trebtrebeon/Banc-acer/05-Conception/05-Conception/05-Conception/Conception Structure.pptx

1000mm

1300mm

1000mm

870mm

## Slide 2

1300mm

1000mm

1000mm

870mm

## Slide 3
