trebtrebeon/Banc-acer/05-Conception/05-Conception/05-Conception/Structure.pptx

1000mm

1300mm

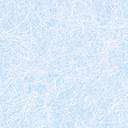
[picture p1: figure]
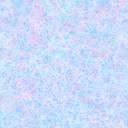
[picture p2: figure]

1000mm

870mm
