trebtrebeon/Banc-acer/01-Cahier des charges/01-Cahier des charges/01-Cahier des charges/Compte rendu du cahier des charges V2.docx

Compte rendu du cahier des charges V2

Suite à la relecture du cahier des charges V2 du projet "Mesure des dimensions des colis" pour le client ACER, nous avons relevé plusieurs incohérences entre le document et ce qu'il nous a été dit lors de la visite chez ACER.

- Le titre du projet est à changer sur les futurs documents : actuellement le projet est appelé "Mesure du volume des colis" alors que son nom réel devrait être "Mesure des dimensions des colis".
- Idem dans le paragraphe des objectifs : actuellement le projet est appelé "Mesure du volume des colis" alors que son nom réel devrait être "Mesure des dimensions des colis".
- Les dimensions des colis communiqués dans le cahier des charges sont erronées, suite à des mesures sur les cartons que nous avons réceptionner de votre part, la plus grande longueur est de 1100 mm, la plus grande largeur est de 650 mm et la plus grande hauteur est de 600 mm.
- Lors de notre visite dans vos services, vous nous avez donné la date de réception (Q1 2020), cependant, sur le document, il est inscrit Q4 2019.

Un retour du client est attendu suite à ce compte rendu du cahier des charges V2.

BTS SNEC 2ème année Projet ACER - Mesure des dimensions des colis
