trebtrebeon/Banc-acer/01-Cahier des charges/01-Cahier des charges/01-Cahier des charges/Résumé des modifications du cahier des charges.docx

Créé le 15/11/19

Modification :

Ajout :

Précision apportée dans le titre et dans l’objectif (volume=>dimensions). Mise à jour des dimensions maximales des cartons. Date de finalisation du projet repoussée à Q1 2020.

Avant Modif :

L‘objectif du projet est de concevoir et fournir un système de mesure du volume des colis.

Après Modif :

L‘objectif du projet est de concevoir et fournir un système de mesure des dimensions des colis.

Avant Modif :

Carton le plus grand : BOX MIXTE : 750x650x400

Carton le plus long : ASPI BALAI : 893x240x302

Carton le plus petit : BOX SMARTPHONE : 200x200x50

Après Modif :

Longueur de carton la plus grande : 110cm

Largeur de carton la plus grande : 65 cm

Hauteur de carton la plus grande : 60cm

Avant Modif :

L’objectif est de finaliser le projet Q4 2019.

Après Modif :

L’objectif est de finaliser le projetpourQ1 2020.
