trebtrebeon/Banc-acer/Projet Acer/Projet Acer/Compte rendu/Compte rendu de la visite Acer.docx

Projet Acer

Tâche en cours de réalisation

- Debug et réécriture du code pour L’écran LCD (Création de la bibliothèque)
- Il sera fourni une documentation d’utilisation.
- Remettre en ordre le dossier avec toutes les documentations techniques. Refaire les schémas de câblage s’il y a besoin.
- Au moment de la livraison, il sera fourni au client des pièces supplémentaire (hors armature) en cas de panne. → Faire un inventaire de toutes les pièces et les commander.

Compte rendu de la visite chez ACER du 14/12/2020

Problème rencontré :

Penser à une autre position de l’écran LCD (le mettre en dessous de la table)

Rajouter des marquages sur la table

Rallongé les buttées environ de 50cm.

Capteur de présence est très sensible à la luminosité.

Il y avait une continuité entre la masse et le 5v sur la carte de prototypage.

Solution :

Capteur de présence : Modification du programme et test ok.

Continuité : Nous avons dessoudé la LED et ça a fonctionné

A faire :

Précision de poids à la centaine de gramme, 50kg

Rallonger le mat pour plus de solidité

Niveau à bulle dans la table pour la mesure plane

Modification des roues.
