trebtrebeon/Banc-acer/Manuel d'utilisation- Banc de mesures Acer.pdf

# Manuel d’utilisation banc de mesures

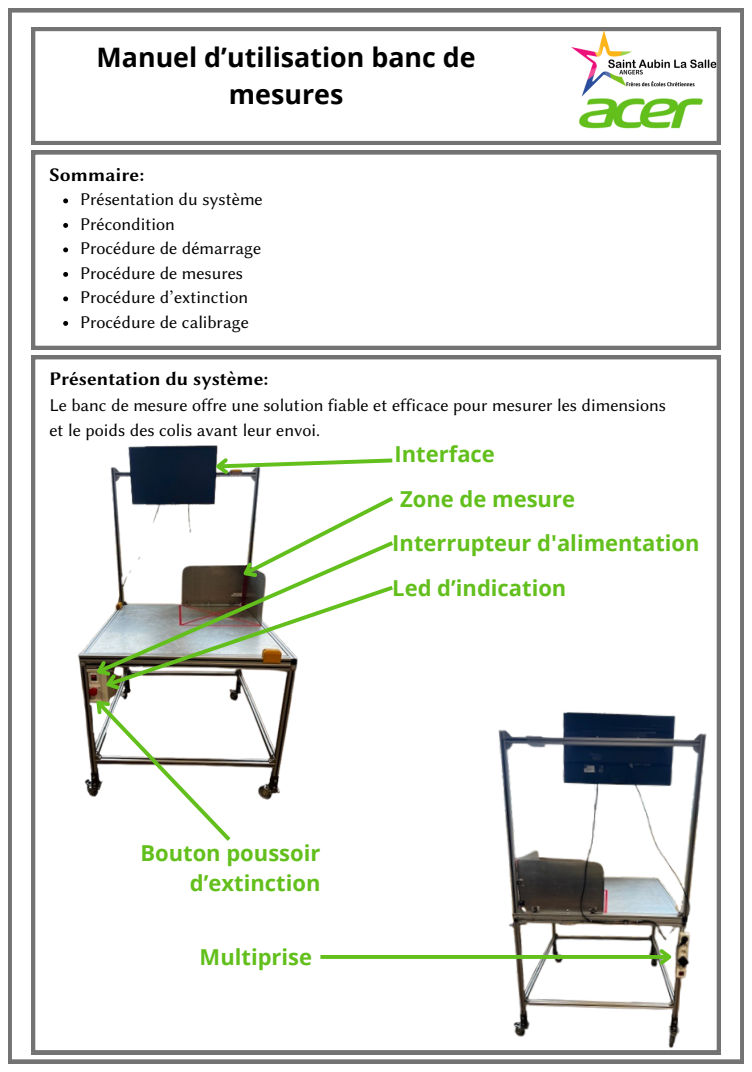
[picture p3: page 1]
Bouton poussoir d’extinction; Multiprise

Sommaire:
Présentation du système
Précondition
Procédure de démarrage
Procédure de mesures
Procédure d’extinction
Procédure de calibrage

Présentation du système:
Le banc de mesure offre une solution fiable et efficace pour mesurer les dimensions
et le poids des colis avant leur envoi.

Interface
Zone de mesure
Interrupteur d'alimentation
Led d’indication

Précondition:
1.Vérifiez que l’interrupteur d'alimentation situé sur la façade est en position OFF (symbole O).
2.Assurez-vous que la multiprise est soit bien branchée et en position OFF (symbole O).
3.Vérifiez qu'il n'y a aucun objet posé sur le banc.

Procédure de démarrage:
1.Allumez la multiprise en position ON (symbole | ).
2.Passez le bouton d'alimentation en position ON (symbole | ).
3.L’écran s’allume et après un certain temps, l’application se lance.

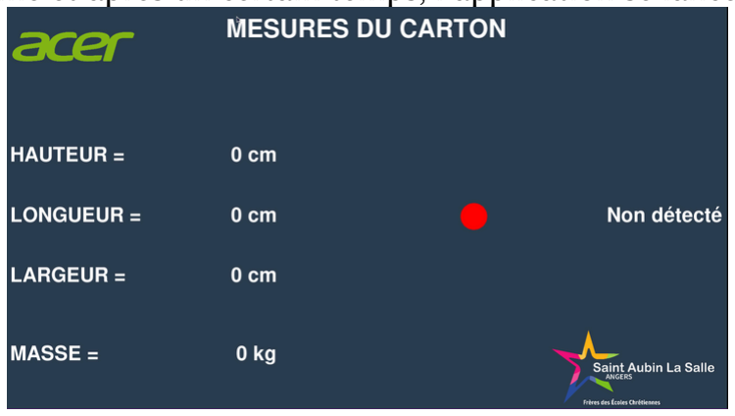
[picture p4: figure]

Procédure de mesures:
1.Placez un carton dans la zone de mesure identifiée (poussez-le jusqu’à la butée). 2.L’indicateur sur l’interface passe en orange la mesure est en cours

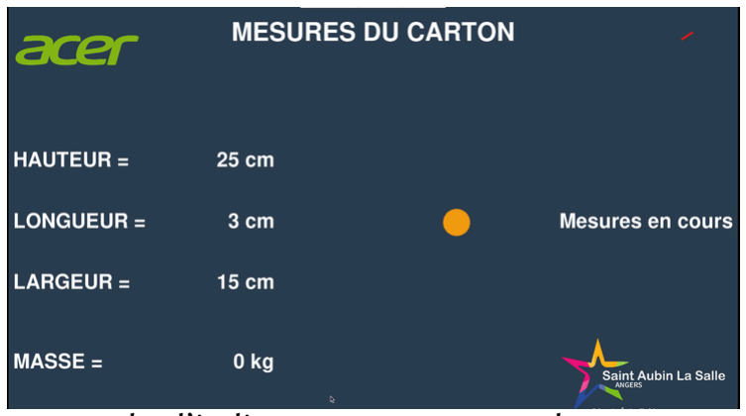
[picture p5: figure]

3.Après quelques secondes l’indicateur passe en vert la mesure est effectué

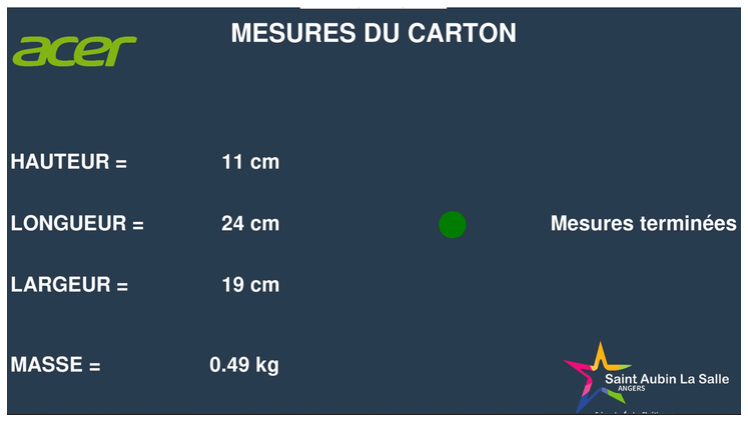
[picture p6: figure]

Procédure d’extinction:
1.Appuyez sur le bouton poussoir d’extinction de la façade et maintenez l’enfoncé jusqu’à la fin du décompte (3 secondes).
2.Attendez que la LED verte (à coté du bouton d’alimentation) soit complètement éteinte.
3.Coupez l'alimentation avec l'interrupteur situé sur la façade (symbole O). 4.Éteignez la multiprise (symbole O).

Procédure de calibrage:
1. Approcher la souris dans le coin haut droit, et le menu calibrage apparaît et . cliquez dessus.
2. Appuyer sur “Lancer le calibrage”
3. Lorsqu’il est affiché (voir image ci-jointe), poser une masse de 20kg dans la zone . de mesure.
4. Lorsqu’il est affiché (voir image ci-jointe), poser une masse de 20kg dans la zone . de mesure.
5. Une fois le calibrage terminé, vous pouvez quitter le menue
