trebtrebeon/Banc-acer/01-Cahier des charges/01-Cahier des charges/01-Cahier des charges/2019-09-24 - Compte rendu visite Acer.docx

# Compte-rendu visite Acer (24/09/19) : Classe de SNEC 2 (Promo 2018-2020), M. Gaudichet, M. Chenus, M. Huteau.

Que fait concrètement l’utilisateur et que devra-t-il faire ?
Que fait l’utilisateur de la mesure ?

- L’opérateur emballe le produit, il prend les dimensions au mètre, il pèse le colis et entre les informations (poids/dimensions) pour avoir le poids volumétrique ce qui va déterminer le coût de transport. Tout est actuellement manuel.

Les cartons sont-ils tous parallélépipédiques ? Sinon, quelles formes ?
De quel espace disposons-nous pour adapter le système ?

- Tous les cartons sont parallélépipédiques et le poste d’installation de l’équipement est aménageable.
- La balance sur laquelle est posé le carton pourra être prise en compte dans la conception dans l’optique de concevoir un système permettant d’éviter une manipulation supplémentaire (prise de dimensions et pesage simultanés). Attention cependant : si une balance tombe en panne, elle sera remplacée par une autre balance pas forcément identique à la première. Ce point ne fait pas partie du cahier des charges initial et n’est donc pas une exigence prioritaire.

Sur quelle durée l’équipement sera-t-il utilisé ?

- Plus de 100 cartons sont mesurés par jour, à une fréquence de 5 jours sur 7 et pendant 7 heures par jour maximum.

Que comprenez-vous dans un coût objectif >500 € ? Ce coût est-il considéré Hors Taxes ou Toutes Taxes Comprises ?

- Le coût objectif de moins de 500 euros HT comprend le matériel nécessaire pour un système. Il a été proposé par le technicien méthode de faire un coin pour caler le carton.

Les résultats doivent-ils être enregistrés ? Sur le réseau ? Si oui, quel est le type de réseau utilisé et comment pouvons-nous y accéder ?

- Les dimensions seront enregistrées dans un espace de stockage externe (disque dur ou clé USB) avec éventuelle réinitialisation.

Que voulez-vous dire par une précision au cm³ ? Sachant que cela demanderait, par exemple, pour la dimension carton BOX MIXTE (750x650x400), une précision capteur de 2µm (ce qui est clairement impossible) ?

- Les dimensions seront affichées en centimètre et auront une précision au centimètre près.

Pouvons-nous afficher autre chose que le résultat à l’écran, commentaires, indications… ?

- Il est possible d’afficher des messages ou autres informations à l’écran.

CFA EC 49 – 15 rue Hélène Boucher, Saint Sylvain d’Anjou, 49481 Verrières en Anjou. Hélène Boucher, Saint Sylvain d’Anjou, 49481 Verrières en ANJOU 1

Projet Acer
