trebtrebeon/Banc-acer/04-Etudes/04-Etudes/04-Etudes/études old/02-Afficheur/Document de conception - Afficheur.docx

Document de conception

Afficheur

Câblage :

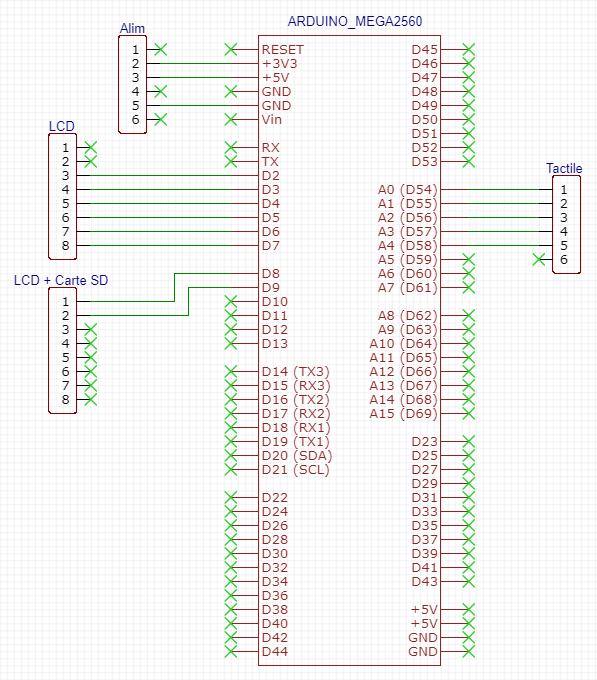
[picture p17: figure]

Interface graphique :

3,5 pouces / 76,2 mm

7,34 mm

4,89 mm

Longueur : xxx,xx cm

Largeur : xxx,xx cm

Hauteur : xxx,xx cm

Date : xx/xx/xxxx

Heure : xxhxxmin

75 pix

110 pix

Longueur : xxx,xx cm

Largeur : xxx,xx cm

Hauteur : xxx,xx cm

Date : xx/xx/xxxx

Heure : xxhxxmin

125 pix

110 pix

Longueur : xxx,xx cm

Largeur : xxx,xx cm

Hauteur : xxx,xx cm

Date : xx/xx/xxxx

Heure : xxhxxmin

200 pix

90 pix

Longueur : xxx,xx cm

Largeur : xxx,xx cm

Hauteur : xxx,xx cm

Date : xx/xx/xxxx

Heure : xxhxxmin

250 pix

70 pix

Longueur : xxx,xx cm

Largeur : xxx,xx cm

Hauteur : xxx,xx cm

Date : xx/xx/xxxx

Heure : xxhxxmin

100 pix

25 pix

Software :

1) Librairie pour utilisation de l’écran
2) Définition des constantes

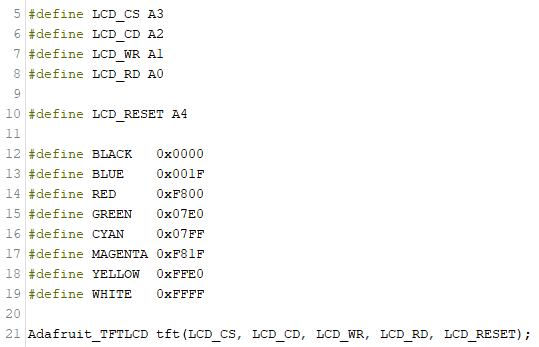
[picture p18: figure]

Partie définition des pins

Partie définition des couleurs

3) Starter

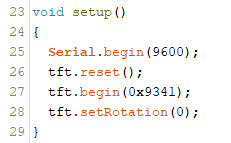
[picture p19: figure]

4) Boucle principal

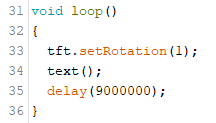
[picture p20: figure]

5) Fonction « text »

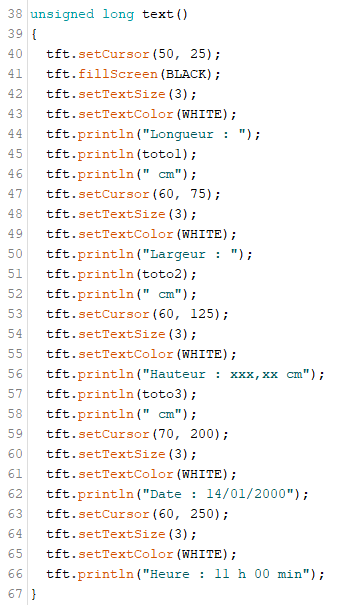
[picture p21: figure]

Partie affichage de la longueur

Partie affichage de la largeur

Partie affichage de la hauteur

Partie affichage de la date

Partie affichage de l’heure

Définition de la couleur de l’écran

Paramétrage Arduino :

Pour choisir le type d’Arduino, il faut aller dans l’onglet « OUTILS », dans la 3ème partie.

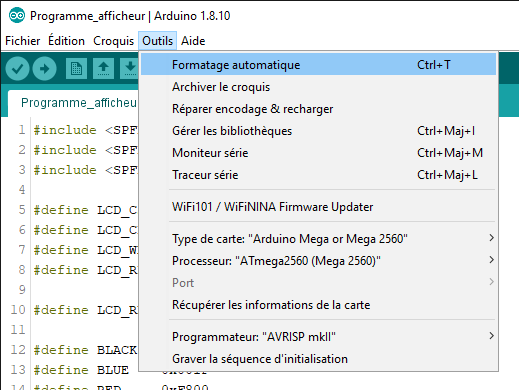
[picture p22: figure]

Paramètre Arduino

Modification taille écran :

Lors du 1er téléversement du programme, l’écran s’affichera en taille réduit, pour cela, il faut :

1) Ouvrir le dossier de la librairie utiliser pour l’afficheur : « SPFD5408-master »
2) Ouvrir le fichier : « SPFD5408_Adafruit_TFTLCD.cpp »
3) Une fois ouvert, il faut mettre en commentaire les lignes 35-36 et décommenter les lignes 32-33

Modification orientation :

Si l’écran n’est pas horizontal, il faut modifié une information dans le code, la procédure est la suivante :

1) Ouvrir le programme du projet
2) Aller dans le « Setup »
3) Sur la ligne « tft.setRotation(x) », au niveau du x, il faut mettre un 1 ou un 0.
