trebtrebeon/Banc-acer/05-Conception/05-Conception/05-Conception/Câblage alimentation.PNG

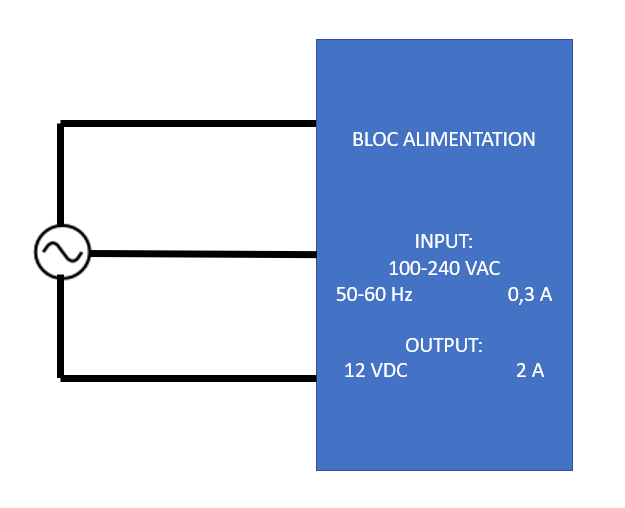
05-Conception/05-Conception/05-Conception/Câblage alimentation.PNG
