trebtrebeon/Banc-acer/05-Conception/05-Conception/05-Conception/devis technic-achat.PNG

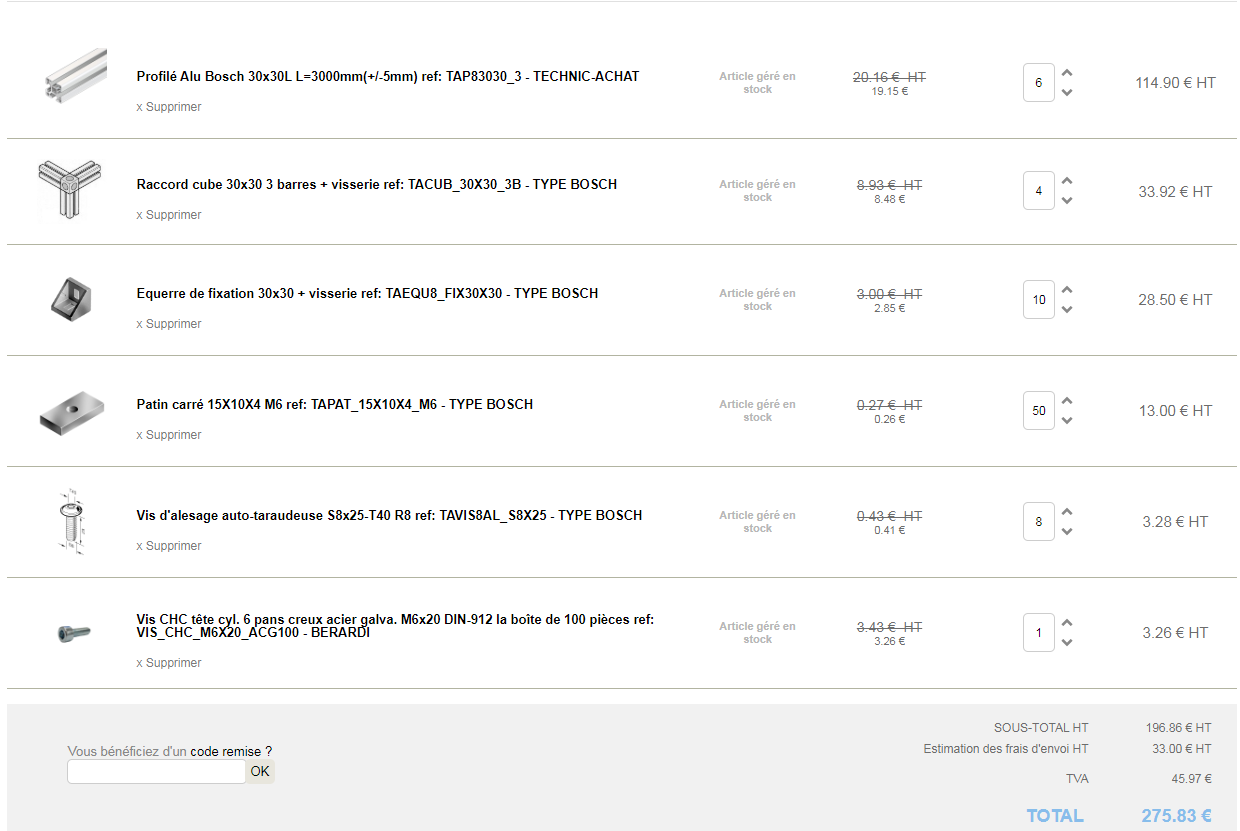
05-Conception/05-Conception/05-Conception/devis technic-achat.PNG
