trebtrebeon/Banc-acer/05-Conception/05-Conception/05-Conception/Schema de cablage capteurs.png

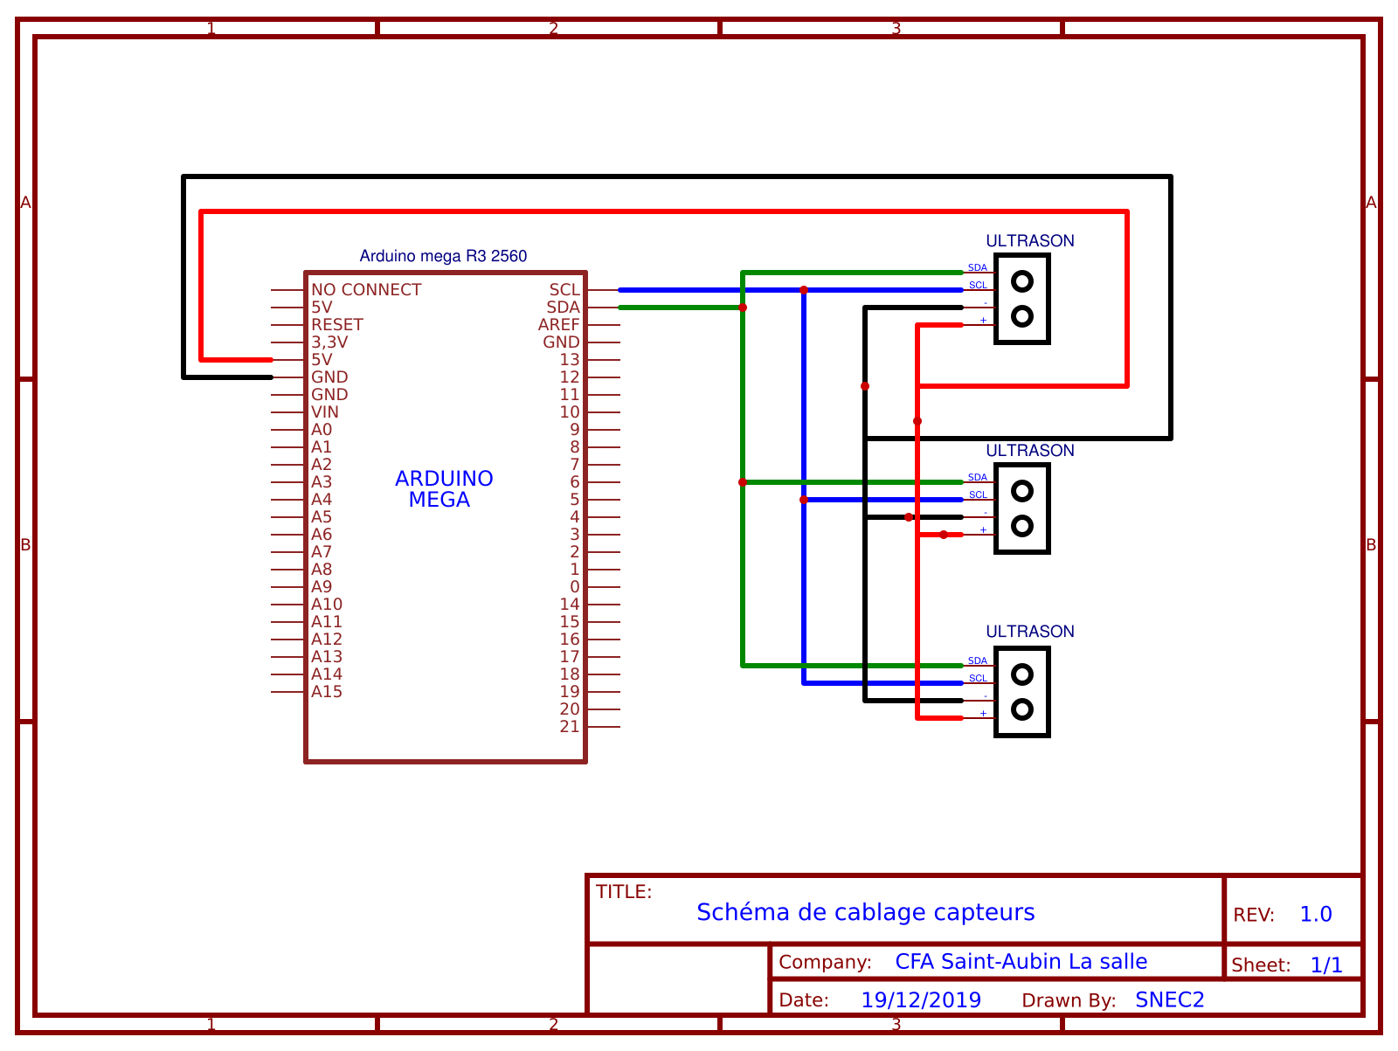
05-Conception/05-Conception/05-Conception/Schema de cablage capteurs.png
