trebtrebeon/Banc-acer/CodesSources/pi/ACER.png

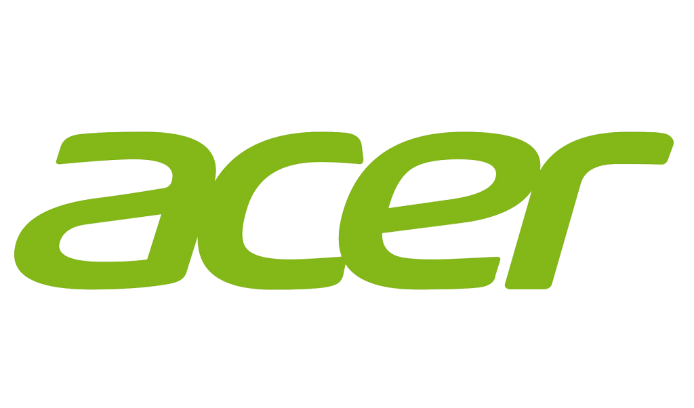
CodesSources/pi/ACER.png
