trebtrebeon/Banc-acer/CodesSources/pi/SALS.png

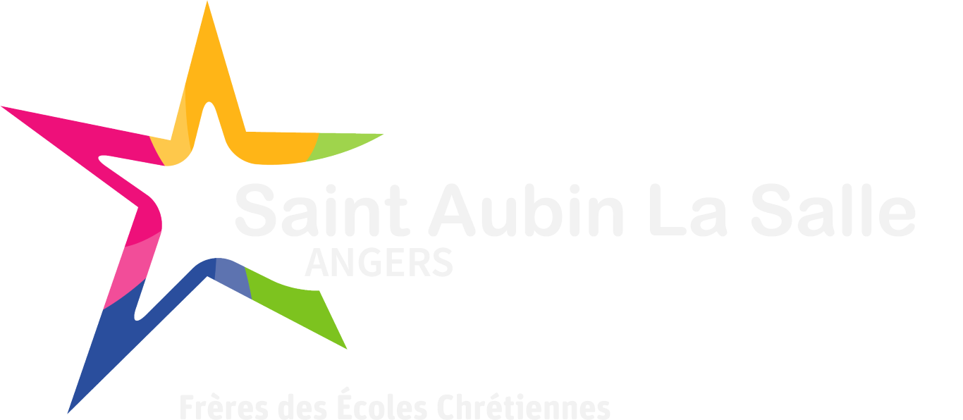
CodesSources/pi/SALS.png
