trebtrebeon/Banc-acer/Projet Acer/Projet Acer/Capteurs/Capteur Ultrasons/Schéma_Câblage_HC-SR04.PNG

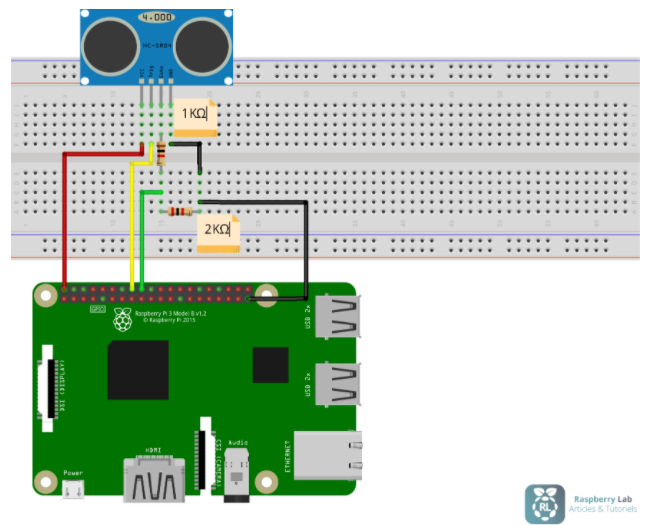
Projet Acer/Projet Acer/Capteurs/Capteur Ultrasons/Schéma_Câblage_HC-SR04.PNG
