trebtrebeon/Banc-acer/Projet Acer/Projet Acer/Méca/Roue/Spécification roulette.PNG

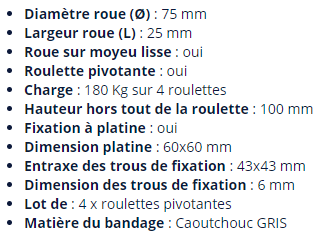
Projet Acer/Projet Acer/Méca/Roue/Spécification roulette.PNG
