trebtrebeon/Banc-acer/05-Conception/05-Conception/05-Conception/commande projet Acer.xlsx

Liste matériel projet ACER (Hors Armature)
Désigantion | Caractéristique | Fournisseur | Référence | Prix HT Unitaire | Unité | Quantité | Prix HT
Arduino MEGA 2560 | Français | Amazon |  | 9.04 € | U | 1 | 9.04 € | https://www.amazon.fr/Semoic-Mega2560-Atmega2560-16AU-Compatible-Arduino/dp/B07PTZ5JV4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
Alimentation Arduino | 12V 2A | Amazon |  | 9.99 € | U | 1 | 9.99 € | https://www.amazon.fr/ZOSI-Adaptateur-Secteur-dalimentation-Transformateur/dp/B015MGWBYE?s=electronics
Module enregistrement |  | Amazon |  | 4.69 € | U | 1 | 4.69 € | https://www.amazon.fr/DEnregistrement-Donn%C3%A9es-DAcquisition-Bouclier-DEnregistreur/dp/B07Y23H6L3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
Carte SD | 4 Go | Amazon |  | 7.99 € | U | 1 | 7.99 € | https://www.amazon.fr/dp/B002WE6CTU/ref=twister_B07STFZ1GF
Écran LCD TFT | 3,5" | Amazon |  | 14.99 € | U | 1 | 14.99 € | https://www.amazon.fr/%C3%89cran-r%C3%A9solution-Support-Arduino-%E2%80%BFMEGA/dp/B07N4KXP5X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
Capteurs lasers | 2 m | Amazon |  | 4.41 € | U | 3 | 13.23 € | https://www.amazon.fr/Tree-Life-GY-VL53L0XV2-d%C3%A9rivation-Distance/dp/B07QZR61D2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
Câbles | 6 bobines | Amazon |  | 16.99 € | U | 1 | 16.99 € | https://www.amazon.fr/d%C3%A9lectronique-silicone-diff%C3%A9rentes-R%C3%A9sistance-temp%C3%A9ratures/dp/B07G715HYY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
Câble 3G | 5 m | Mano Mano |  | 0.69 € | L | 5 | 3.45 € | https://www.manomano.fr/p/cable-r2v-3g4-8540275?model_id=8540287
Fiche électrique |  | Amazon |  | 4.99 € | U | 1 | 4.99 € | https://www.amazon.fr/Legrand-LEG93828-Fiche-Etanche-Plexo/dp/B00A7MCCIY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
Capteurs ultrasons |  | MouserElectronic |  | 11.61 € | U | 3 | 34.83 € | https://www.mouser.fr/ProductDetail/DFRobot/SEN0304
 |  |  |  |  |  | Total | 120.19 €
