trebtrebeon/Banc-acer/Projet Acer/Projet Acer/Bon de commande/Commande projet Acer.xlsx

Mise à jour du bon de commande 13/12/2020
N° Article | Description | Fournisseur | Qté Livrée | Prix HT Unitaire | Prix TTC | Documentation technique
34732 | Amplificateur pour capteur de force SEN-13879 | GO TRONIC | 2 | 10.80 € | 21.60 € | https://www.gotronic.fr/art-amplificateur-pour-capteur-de-force-sen-13879-25334.htm#complte_desc
RB-Spa-488 | Capteur de poids 50 kg SFE | Robot Shop | 4 | 9.28 € | 37.12 € | https://www.robotshop.com/eu/fr/capteur-poids-50-kg-sfe.html
/ | Aussel Câble plat de couleur d'arc-en-ciel de câble de 1.27mm pour des connecteurs de 2.54mm (30Wire/3M) | Amazon | 1 | 9.99 € | 9.99 € | https://www.amazon.fr/Aussel-couleur-darc-en-ciel-1-27mm-connecteurs/dp/B077XF5LXH
/ | QLOUNI 560 pcs 18-26 AWG Connecteur JST-XHP Câble Kit 2.54mm Femelle Pin Header JST-PH 2/3/4/5 Pin Connecteur Mâle et Femelle | AMAZON | 1 | 12.99 € | 12.99 € | https://www.amazon.fr/dp/B0774R1RN1
6662893 | Connecteur Sub-D HARTING 15 voies Femelle Montage sur câble Droit | RS Components | 2 | 3.32 € | 16.31 € | https://fr.rs-online.com/web/p/connecteurs-sub-d/6662893/
/ | LINDY Support pour Ecran avec Mât et Fixation à Pince | AMAZON | 1 | 32.63 € | 32.63 € | https://www.amazon.fr/LINDY-Support-Ecran-Fixation-Pince/dp/B083PDBJ25
ME4024847 | Lot roulettes pivotantes caoutchouc gris 75 mm - 180 Kg | Mano Mano | Lot de 4 | 17.89 € | 17.89 € | https://www.manomano.fr/p/lot-roulettes-pivotantes-caoutchouc-gris-75-mm-180-kg-4024847
104155 | Boîtier Fibox TEMPO en ABS, 187.2 x 122.2 x 89.9mm, Gris IP65 | RS Components | 1 | 10.75 € | 12.90 € | https://fr.rs-online.com/web/p/boitiers-pour-usage-general/0104155/
/ | ELEGOO 5 pièces HC-SR04 Module Ultrason de Capteur de Distance Ultrasonic Module Distance Sensor | AMAZON | 5 | / | 8.99 € | https://www.amazon.fr/gp/product/B06XSJPVW9/ref=ox_sc_act_title_1?smid=AZF7WYXU5ZANW&psc=1
/ | SanDisk Carte Mémoire MicroSDHC Ultra 32 Go + Adaptateur SD. Vitesse de Lecture Allant jusqu'à 98MB/S, Classe 10, U1, homologuée A1 | AMAZON | 1 | 8.74 € | 8.74 € | https://www.amazon.fr/gp/product/B073JWXGNT/ref=ox_sc_act_title_2?smid=A3CNB4T4PHDD3G&psc=1
/ | RAMPOW Câble USB Type C vers USB 3.0, Câble USB C Charge Rapide 3A, Chargeur USB C Nylon Tressé avec Connecteur Résistant pour Samsung S8/S9/S10 Note 10, Xiaomi, Sony et Plus - 1m/Gris Sidéral | AMAZON | 1 | 6.99 € | 6.99 € | https://www.amazon.fr/gp/product/B01N4OKUB8/ref=ox_sc_act_title_3?smid=A54WM2317NJ70&th=1
/ | Câble micro HDMI vers HDMI par LinkinPerk, câble HDMI haute vitesse vers micro HDMI HDTV, prend en charge Ethernet, 3D, 4 K et retour audio | AMAZON | 1 | 8.09 € | 8.09 € | https://www.amazon.fr/gp/product/B072J9FLN4/ref=ox_sc_act_title_4?smid=A3M5K1HE9PQRI0&psc=1
/ | Raspberry Pi 4 Modèle B 4 Go ARM-Cortex-A72 4 x 1,50 GHz, 4 Go de RAM, WLAN-AC, Bluetooth 5, LAN, 4 x USB, 2 x Micro HDMI | RS Components | 1 | 49.21 € | 59.05 € | https://fr.rs-online.com/web/p/raspberry-pi/1822096/
