trebtrebeon/Banc-acer/05-Conception/05-Conception/05-Conception/DEVIS STRUCTURE.xlsx

DESCRIPTION | FOURNISSEUR | RÉFERENCE | PRIX TTC | PRIX HT | QUANTITÉ | PRIX TOTAL HT
Profilé aluminium 30x30, rainures 8mm, longueur 3000mm | Technic-Achat | TAP83030_3 | 24.26 € | 20.22 € | 6 | 121.32 €
Raccord cube 30x30, 3 barres + visserie | Technic-Achat | TACUB_30x30_3B | 10.72 € | 8.93 € | 4 | 35.72 €
Equerre de fixation 30x30 + visserie | Technic-Achat | TAEQU8_FIX30x30 | 3.60 € | 3.00 € | 10 | 30.00 €
Patin carré 15x10x4 M6 | Technic-Achat | TAPAT_15X10X4_M6 | 0.32 € | 0.27 € | 50 | 13.50 €
Vis d'alesage auto-taraudeuse S8x25-T40 R8 | Technic-Achat | TAVIS8AL_S8X25 | 0.54 € | 0.45 € | 8 | 3.60 €
Vis CHC tête cylindrique 6 pans creux, M6x20 (100 pcs) | Technic-Achat | VIS_CHC_M6X20_ACG100 | 4.12 € | 3.43 € | 1 | 3.43 €
REDUCTION |  |  |  |  |  | 10.71 €
SOUS TOTAL HT |  |  |  |  |  | 196.86 €
FRAIS DE TRANSPORT |  |  |  |  |  | 33.00 €
TVA |  |  |  |  |  | 45.97 €
PRIX TOTAL TTC |  |  |  |  |  | 275.83 €
