trebtrebeon/Banc-acer/05-Conception/05-Conception/05-Conception/Assemblage1.IGS

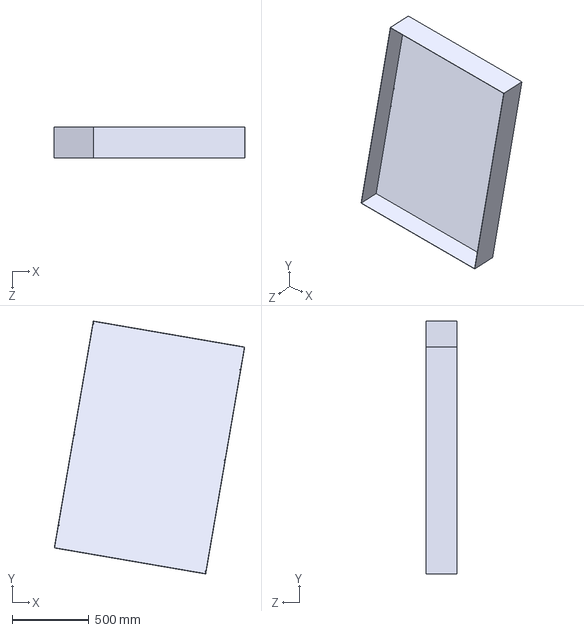
[picture p45: CAD file, 2025-03-12]
05-Conception/05-Conception/05-Conception/Assemblage1.IGS
1244.3 x 1652.3 x 200.0 mm
