trebtrebeon/Banc-acer/Fichiers 3D Acer/Support 2 RPI Acer.stl

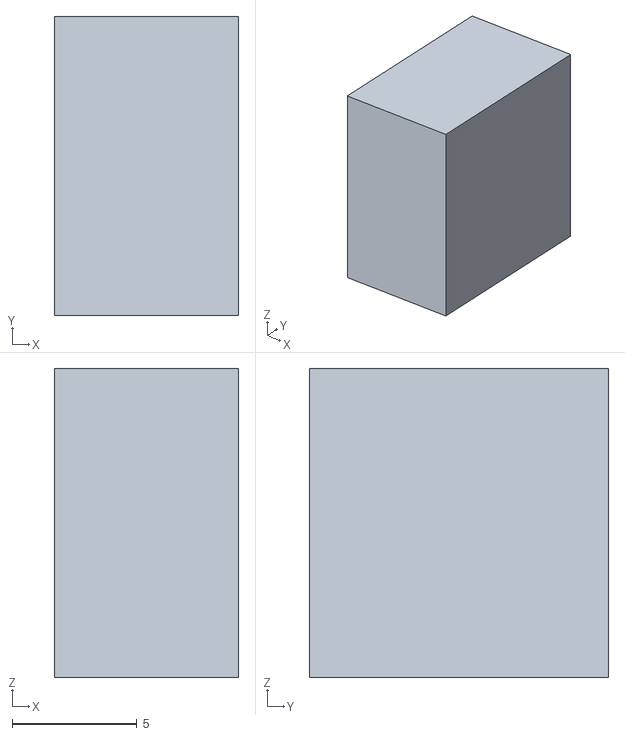
[picture p46: CAD file, 2025-05-21]
Fichiers 3D Acer/Support 2 RPI Acer.stl
7.40 x 12.0 x 12.4
