trebtrebeon/Banc-acer/05-Conception/05-Conception/05-Conception/Mat.IGS

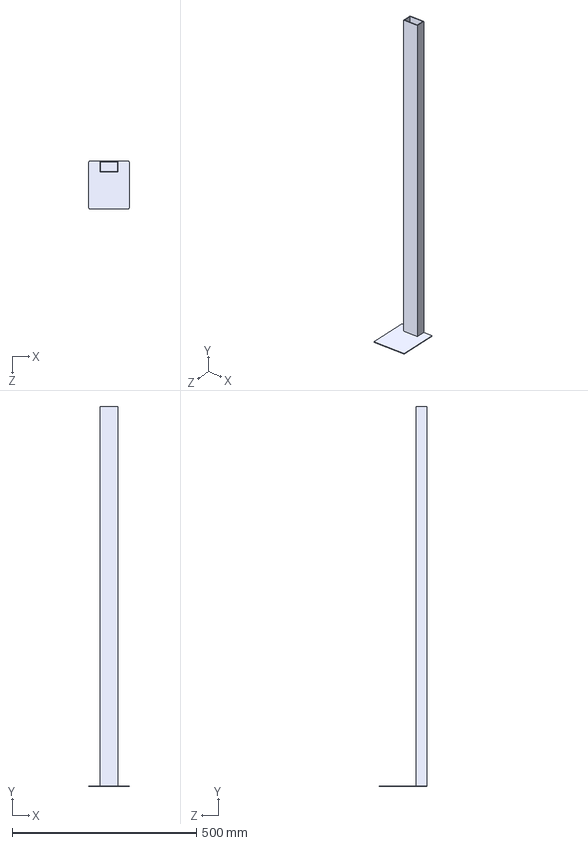
[picture p47: CAD file, 2025-03-12]
05-Conception/05-Conception/05-Conception/Mat.IGS
110.0 x 1032.0 x 130.0 mm
