trebtrebeon/Banc-acer/Fichiers 3D Acer/Entretoise Acer.stl

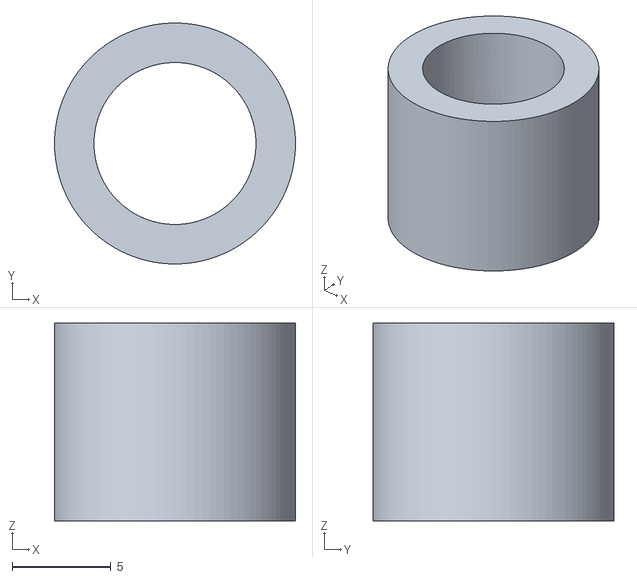
[picture p48: CAD file, 2025-05-21]
Fichiers 3D Acer/Entretoise Acer.stl
12.2 x 12.2 x 10.0
