trebtrebeon/Banc-acer/Fichiers 3D Acer/Zip_tie_mount-3030_pyramid.stl

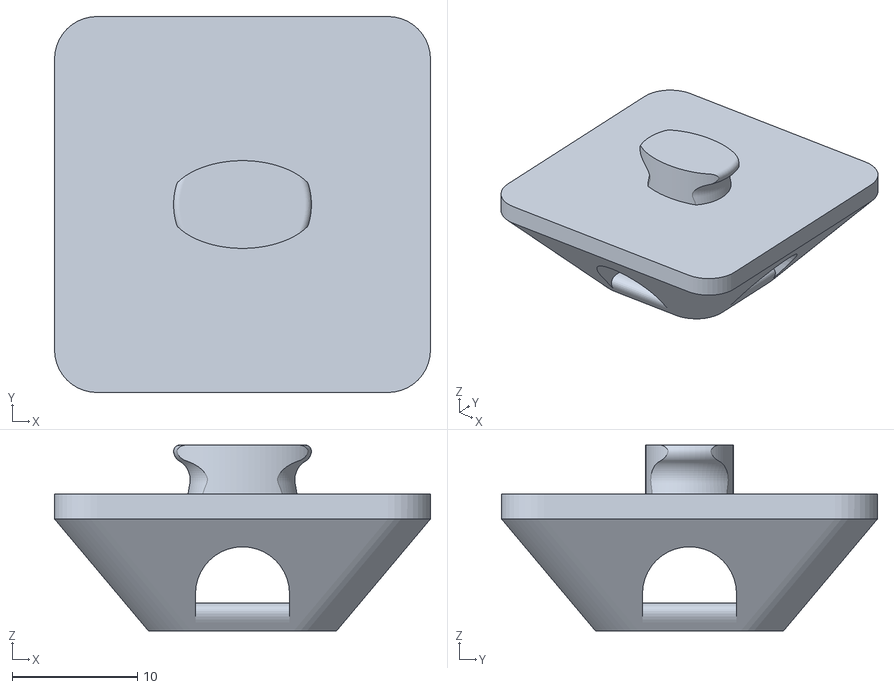
[picture p49: CAD file, 2025-05-21]
Fichiers 3D Acer/Zip_tie_mount-3030_pyramid.stl
30.0 x 30.0 x 14.8
