trebtrebeon/Banc-acer/Fichiers 3D Acer/Support RPI Acer.stl

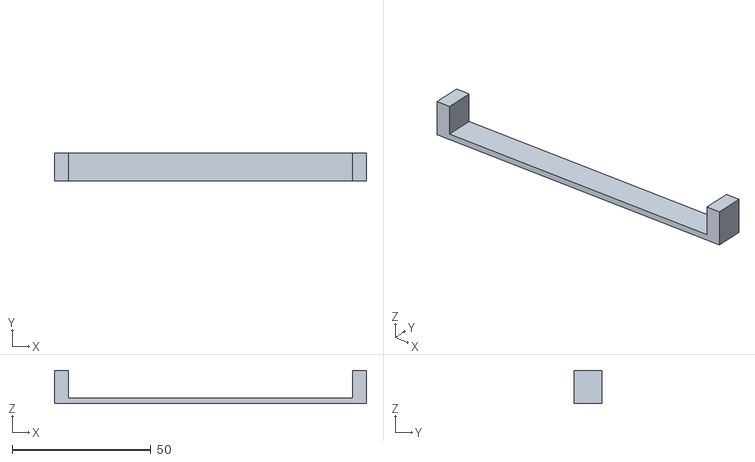
[picture p50: CAD file, 2025-05-21]
Fichiers 3D Acer/Support RPI Acer.stl
112.5 x 10.0 x 12.0
