trebtrebeon/Banc-acer/Fichiers 3D Acer/Calle Capteur ultrason Acer V2.stl

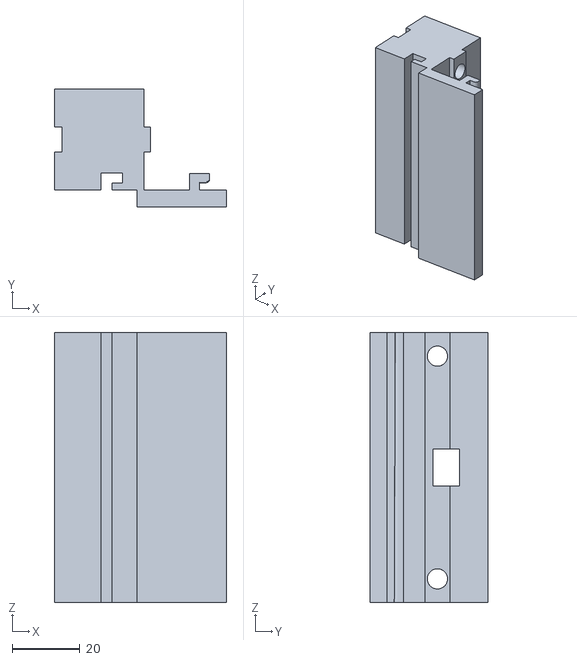
[picture p51: CAD file, 2025-05-21]
Fichiers 3D Acer/Calle Capteur ultrason Acer V2.stl
51.0 x 35.0 x 80.0
