trebtrebeon/Banc-acer/04-Etudes/04-Etudes/04-Etudes/études old/02-Afficheur/SW/Boitier Afficheur/Boitier Afficheur.SLDPRT

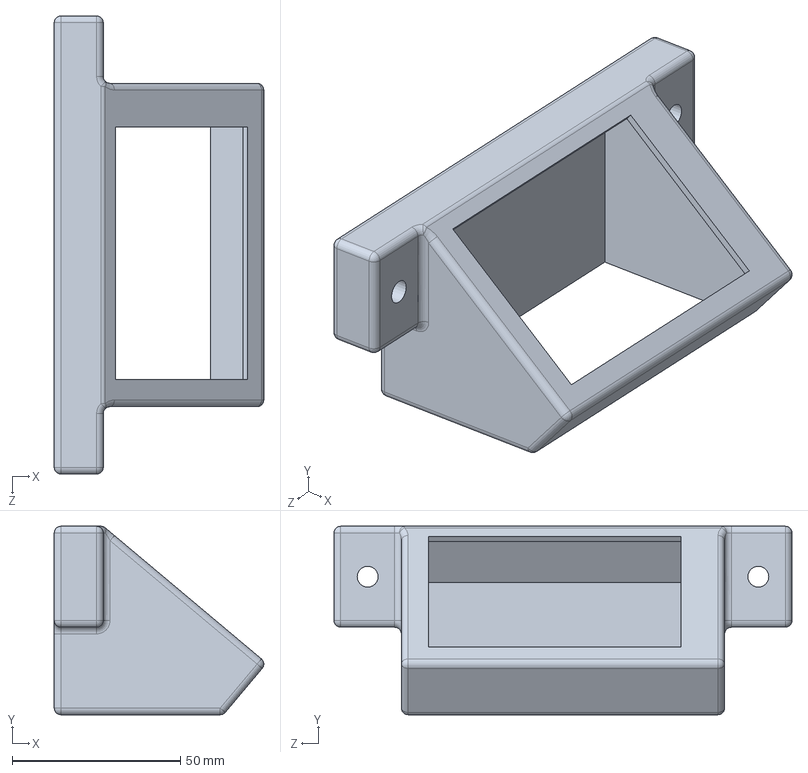
[picture p52: CAD file, 2025-03-12, an earlier design]
04-Etudes/04-Etudes/04-Etudes/études old/02-Afficheur/SW/Boitier Afficheur/Boitier Afficheur.SLDPRT
62.3 x 56.0 x 136.0 mm
