trebtrebeon/Banc-acer/04-Etudes/04-Etudes/04-Etudes/études old/02-Afficheur/SW/Couvercle Afficheur/Couvercle Afficheur.SLDPRT

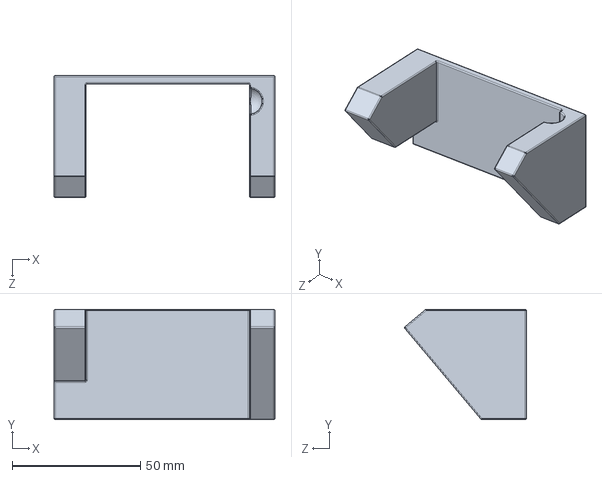
[picture p53: CAD file, 2025-03-12, an earlier design]
04-Etudes/04-Etudes/04-Etudes/études old/02-Afficheur/SW/Couvercle Afficheur/Couvercle Afficheur.SLDPRT
86.0 x 42.9 x 47.4 mm
