trebtrebeon/Banc-acer/04-Etudes/04-Etudes/04-Etudes/études old/03-Stockage/Test document stockage/06022106.CSV

2106/2/6 | 6:28:19 | Longueur : XXX cm | Largeur : XXX cm | Hauteur : XXX cm
2106/2/6 | 6:28:19 | Longueur : XXX cm | Largeur : XXX cm | Hauteur : XXX cm
2106/2/6 | 6:28:19 | Longueur : XXX cm | Largeur : XXX cm | Hauteur : XXX cm
2106/2/6 | 6:28:25 | Longueur : XXX cm | Largeur : XXX cm | Hauteur : XXX cm
2106/2/6 | 6:28:31 | Longueur : XXX cm | Largeur : XXX cm | Hauteur : XXX cm
2106/2/6 | 6:28:37 | Longueur : XXX cm | Largeur : XXX cm | Hauteur : XXX cm
