trebtrebeon/Banc-acer/04-Etudes/04-Etudes/04-Etudes/études old/03-Stockage/Test document stockage/13022020.CSV

2020/2/13 | 9:30:32 | Longueur : XXX cm | Largeur : XXX cm | Hauteur : XXX cm
2020/2/13 | 9:30:38 | Longueur : XXX cm | Largeur : XXX cm | Hauteur : XXX cm
2020/2/13 | 9:30:44 | Longueur : XXX cm | Largeur : XXX cm | Hauteur : XXX cm
2020/2/13 | 9:30:50 | Longueur : XXX cm | Largeur : XXX cm | Hauteur : XXX cm
2020/2/13 | 9:30:56 | Longueur : XXX cm | Largeur : XXX cm | Hauteur : XXX cm
2020/2/13 | 9:31:2 | Longueur : XXX cm | Largeur : XXX cm | Hauteur : XXX cm
2020/2/13 | 9:31:8 | Longueur : XXX cm | Largeur : XXX cm | Hauteur : XXX cm
2020/2/13 | 9:31:14 | Longueur : XXX cm | Largeur : XXX cm | Hauteur : XXX cm
2020/2/13 | 9:31:20 | Longueur : XXX cm | Largeur : XXX cm | Hauteur : XXX cm
2020/2/13 | 9:31:26 | Longueur : XXX cm | Largeur : XXX cm | Hauteur : XXX cm
2020/2/13 | 9:31:32 | Longueur : XXX cm | Largeur : XXX cm | Hauteur : XXX cm
2020/2/13 | 9:31:38 | Longueur : XXX cm | Largeur : XXX cm | Hauteur : XXX cm
2020/2/13 | 9:31:44 | Longueur : XXX cm | Largeur : XXX cm | Hauteur : XXX cm
2020/2/13 | 9:31:50 | Longueur : XXX cm | Largeur : XXX cm | Hauteur : XXX cm
2020/2/13 | 9:31:56 | Longueur : XXX cm | Largeur : XXX cm | Hauteur : XXX cm
2020/2/13 | 9:32:2 | Longueur : XXX cm | Largeur : XXX cm | Hauteur : XXX cm
2020/2/13 | 9:32:8 | Longueur : XXX cm | Largeur : XXX cm | Hauteur : XXX cm
2020/2/13 | 9:32:14 | Longueur : XXX cm | Largeur : XXX cm | Hauteur : XXX cm
2020/2/13 | 9:32:20 | Longueur : XXX cm | Largeur : XXX cm | Hauteur : XXX cm
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
2020/2/13 | 9:56:57 | Longueur : XXX cm | Largeur : XXX cm | Hauteur : XXX cm
2020/2/13 | 9:57:3 | Longueur : XXX cm | Largeur : XXX cm | Hauteur : XXX cm
2020/2/13 | 9:57:9 | Longueur : XXX cm | Largeur : XXX cm | Hauteur : XXX cm
2020/2/13 | 9:57:15 | Longueur : XXX cm | Largeur : XXX cm | Hauteur : XXX cm
2020/2/13 | 9:57:21 | Longueur : XXX cm | Largeur : XXX cm | Hauteur : XXX cm
2020/2/13 | 9:57:27 | Longueur : XXX cm | Largeur : XXX cm | Hauteur : XXX cm
2020/2/13 | 9:57:33 | Longueur : XXX cm | Largeur : XXX cm | Hauteur : XXX cm
2020/2/13 | 9:57:39 | Longueur : XXX cm | Largeur : XXX cm | Hauteur : XXX cm
2020/2/13 | 9:57:45 | Longueur : XXX cm | Largeur : XXX cm | Hauteur : XXX cm
2020/2/13 | 9:57:51 | Longueur : XXX cm | Largeur : XXX cm | Hauteur : XXX cm
2020/2/13 | 9:57:57 | Longueur : XXX cm | Largeur : XXX cm | Hauteur : XXX cm
2020/2/13 | 9:58:3 | Longueur : XXX cm | Largeur : XXX cm | Hauteur : XXX cm
2020/2/13 | 9:58:9 | Longueur : XXX cm | Largeur : XXX cm | Hauteur : XXX cm
