trebtrebeon/Banc-acer/04-Etudes/04-Etudes/04-Etudes/études old/03-Stockage/Test document stockage/14012020.CSV

2020/1/14 | 11:0:44 | Longueur : XXX cm | Largeur : XXX cm | Hauteur : XXX cm
2020/1/14 | 11:0:50 | Longueur : XXX cm | Largeur : XXX cm | Hauteur : XXX cm
2020/1/14 | 11:0:56 | Longueur : XXX cm | Largeur : XXX cm | Hauteur : XXX cm
2020/1/14 | 11:1:2 | Longueur : XXX cm | Largeur : XXX cm | Hauteur : XXX cm
2020/1/14 | 11:1:8 | Longueur : XXX cm | Largeur : XXX cm | Hauteur : XXX cm
2020/1/14 | 11:1:14 | Longueur : XXX cm | Largeur : XXX cm | Hauteur : XXX cm
2020/1/14 | 11:1:20 | Longueur : XXX cm | Largeur : XXX cm | Hauteur : XXX cm
2020/1/14 | 11:0:44 | Longueur : XXX cm | Largeur : XXX cm | Hauteur : XXX cm
2020/1/14 | 11:0:50 | Longueur : XXX cm | Largeur : XXX cm | Hauteur : XXX cm
2020/1/14 | 11:0:56 | Longueur : XXX cm | Largeur : XXX cm | Hauteur : XXX cm
2020/1/14 | 11:1:2 | Longueur : XXX cm | Largeur : XXX cm | Hauteur : XXX cm
2020/1/14 | 11:1:8 | Longueur : XXX cm | Largeur : XXX cm | Hauteur : XXX cm
2020/1/14 | 11:1:14 | Longueur : XXX cm | Largeur : XXX cm | Hauteur : XXX cm
2020/1/14 | 11:1:20 | Longueur : XXX cm | Largeur : XXX cm | Hauteur : XXX cm
2020/1/14 | 11:1:26 | Longueur : XXX cm | Largeur : XXX cm | Hauteur : XXX cm
2020/1/14 | 11:1:32 | Longueur : XXX cm | Largeur : XXX cm | Hauteur : XXX cm
2020/1/14 | 11:1:38 | Longueur : XXX cm | Largeur : XXX cm | Hauteur : XXX cm
2020/1/14 | 11:1:44 | Longueur : XXX cm | Largeur : XXX cm | Hauteur : XXX cm
2020/1/14 | 11:1:50 | Longueur : XXX cm | Largeur : XXX cm | Hauteur : XXX cm
2020/1/14 | 11:1:56 | Longueur : XXX cm | Largeur : XXX cm | Hauteur : XXX cm
2020/1/14 | 11:2:2 | Longueur : XXX cm | Largeur : XXX cm | Hauteur : XXX cm
2020/1/14 | 11:2:8 | Longueur : XXX cm | Largeur : XXX cm | Hauteur : XXX cm
2020/1/14 | 11:2:14 | Longueur : XXX cm | Largeur : XXX cm | Hauteur : XXX cm
2020/1/14 | 11:2:20 | Longueur : XXX cm | Largeur : XXX cm | Hauteur : XXX cm
2020/1/14 | 11:2:26 | Longueur : XXX cm | Largeur : XXX cm | Hauteur : XXX cm
2020/1/14 | 11:2:32 | Longueur : XXX cm | Largeur : XXX cm | Hauteur : XXX cm
2020/1/14 | 10:52:3 | Longueur : XXX cm | Largeur : XXX cm | Hauteur : XXX cm
2020/1/14 | 10:52:3 | Longueur : XXX cm | Largeur : XXX cm | Hauteur : XXX cm
2020/1/14 | 10:52:9 | Longueur : XXX cm | Largeur : XXX cm | Hauteur : XXX cm
2020/1/14 | 10:52:15 | Longueur : XXX cm | Largeur : XXX cm | Hauteur : XXX cm
2020/1/14 | 10:52:21 | Longueur : XXX cm | Largeur : XXX cm | Hauteur : XXX cm
2020/1/14 | 10:52:27 | Longueur : XXX cm | Largeur : XXX cm | Hauteur : XXX cm
2020/1/14 | 11:32:3 | Longueur : XXX cm | Largeur : XXX cm | Hauteur : XXX cm
2020/1/14 | 11:59:13 | Longueur : XXX cm | Largeur : XXX cm | Hauteur : XXX cm
2020/1/14 | 11:59:19 | Longueur : XXX cm | Largeur : XXX cm | Hauteur : XXX cm
2020/1/14 | 11:59:25 | Longueur : XXX cm | Largeur : XXX cm | Hauteur : XXX cm
2020/1/14 | 11:59:31 | Longueur : XXX cm | Largeur : XXX cm | Hauteur : XXX cm
2020/1/14 | 12:1:9 | Longueur : XXX cm | Largeur : XXX cm | Hauteur : XXX cm
2020/1/14 | 12:1:15 | Longueur : XXX cm | Largeur : XXX cm | Hauteur : XXX cm
