trebtrebeon/Banc-acer/04-Etudes/04-Etudes/04-Etudes/études old/03-Stockage/Test document stockage/16012020.CSV

2020/1/16 | 8:25:42 | Longueur : XXX cm | Largeur : XXX cm | Hauteur : XXX cm
2020/1/16 | 8:25:49 | Longueur : XXX cm | Largeur : XXX cm | Hauteur : XXX cm
2020/1/16 | 8:25:59 | Longueur : XXX cm | Largeur : XXX cm | Hauteur : XXX cm
2020/1/16 | 8:26:8 | Longueur : XXX cm | Largeur : XXX cm | Hauteur : XXX cm
2020/1/16 | 8:26:14 | Longueur : XXX cm | Largeur : XXX cm | Hauteur : XXX cm
2020/1/16 | 8:26:20 | Longueur : XXX cm | Largeur : XXX cm | Hauteur : XXX cm
2020/1/16 | 8:26:26 | Longueur : XXX cm | Largeur : XXX cm | Hauteur : XXX cm
2020/1/16 | 8:26:32 | Longueur : XXX cm | Largeur : XXX cm | Hauteur : XXX cm
2020/1/16 | 8:26:38 | Longueur : XXX cm | Largeur : XXX cm | Hauteur : XXX cm
2020/1/16 | 8:29:49 | Longueur : XXX cm | Largeur : XXX cm | Hauteur : XXX cm
2020/1/16 | 8:29:55 | Longueur : XXX cm | Largeur : XXX cm | Hauteur : XXX cm
2020/1/16 | 8:30:1 | Longueur : XXX cm | Largeur : XXX cm | Hauteur : XXX cm
2020/1/16 | 8:30:7 | Longueur : XXX cm | Largeur : XXX cm | Hauteur : XXX cm
2020/1/16 | 8:30:13 | Longueur : XXX cm | Largeur : XXX cm | Hauteur : XXX cm
2020/1/16 | 8:30:19 | Longueur : XXX cm | Largeur : XXX cm | Hauteur : XXX cm
2020/1/16 | 8:30:25 | Longueur : XXX cm | Largeur : XXX cm | Hauteur : XXX cm
2020/1/16 | 8:30:31 | Longueur : XXX cm | Largeur : XXX cm | Hauteur : XXX cm
2020/1/16 | 8:30:37 | Longueur : XXX cm | Largeur : XXX cm | Hauteur : XXX cm
2020/1/16 | 8:30:43 | Longueur : XXX cm | Largeur : XXX cm | Hauteur : XXX cm
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
2020/1/16 | 9:26:21 | Longueur : XXX cm | Largeur : XXX cm | Hauteur : XXX cm
2020/1/16 | 9:26:27 | Longueur : XXX cm | Largeur : XXX cm | Hauteur : XXX cm
2020/1/16 | 9:26:33 | Longueur : XXX cm | Largeur : XXX cm | Hauteur : XXX cm
