trebtrebeon/Banc-acer/04-Etudes/04-Etudes/04-Etudes/études old/03-Stockage/Test document stockage/23012020.CSV

2020/1/23 | 8:22:56 | Longueur : XXX cm | Largeur : XXX cm | Hauteur : XXX cm
2020/1/23 | 8:23:2 | Longueur : XXX cm | Largeur : XXX cm | Hauteur : XXX cm
2020/1/23 | 8:23:8 | Longueur : XXX cm | Largeur : XXX cm | Hauteur : XXX cm
2020/1/23 | 8:23:14 | Longueur : XXX cm | Largeur : XXX cm | Hauteur : XXX cm
2020/1/23 | 8:23:21 | Longueur : XXX cm | Largeur : XXX cm | Hauteur : XXX cm
2020/1/23 | 8:23:27 | Longueur : XXX cm | Largeur : XXX cm | Hauteur : XXX cm
2020/1/23 | 8:23:33 | Longueur : XXX cm | Largeur : XXX cm | Hauteur : XXX cm
2020/1/23 | 8:23:39 | Longueur : XXX cm | Largeur : XXX cm | Hauteur : XXX cm
2020/1/23 | 8:23:45 | Longueur : XXX cm | Largeur : XXX cm | Hauteur : XXX cm
2020/1/23 | 8:23:51 | Longueur : XXX cm | Largeur : XXX cm | Hauteur : XXX cm
2020/1/23 | 8:23:57 | Longueur : XXX cm | Largeur : XXX cm | Hauteur : XXX cm
2020/1/23 | 8:24:3 | Longueur : XXX cm | Largeur : XXX cm | Hauteur : XXX cm
2020/1/23 | 8:24:9 | Longueur : XXX cm | Largeur : XXX cm | Hauteur : XXX cm
2020/1/23 | 8:24:15 | Longueur : XXX cm | Largeur : XXX cm | Hauteur : XXX cm
2020/1/23 | 8:24:21 | Longueur : XXX cm | Largeur : XXX cm | Hauteur : XXX cm
2020/1/23 | 8:24:27 | Longueur : XXX cm | Largeur : XXX cm | Hauteur : XXX cm
